thieu-b55/GPS-synchronized-clock/Klok met voet.jpg

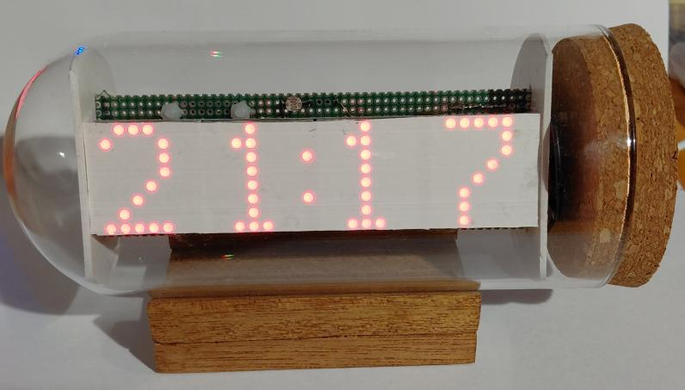
Klok met voet.jpg
