thieu-b55/GPS-synchronized-clock/GPS klok(NL).pdf

## GPS Klok

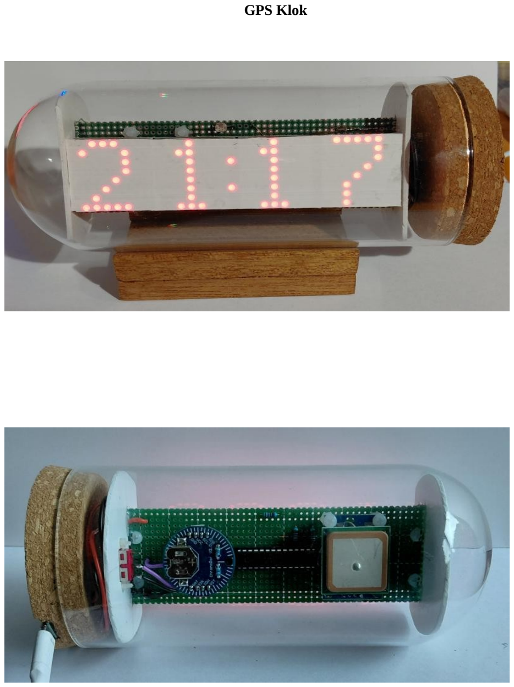
[picture p9: page 1]

GPS-gesynchroniseerde klok

Eenvoudige klok die altijd de juiste tijd aangeeft. GPS-ontvangst vereist.

De keuze tussen zomer- en wintertijd moet handmatig worden gemaakt.

Slechts enkele componenten en eenvoudig te bouwen, zelfs op een breadboard.

Gebouwd rond een ATMEGA328P-chip of bord.

Gebruik een Arduino Mini Pro 5V-versie om in de glazen stolp te monteren.

of

ATMEGA328P-chip met een voedingsspanning van 5 V.

De LED-matrix is niet compatibel met 3,3 V.

Gebruik de volgende instellingen bij gebruik van de ATMEGA328P-chip:

Bootloader: "Geen bootloader"

Klok: "Intern 8 MHz"

Geen financiële impact

Ideaal voor Arduino-beginners

Seriële communicatie

I2C-communicatie

SPI-communicatie

Analoge ingang

Digitale ingang

Interrupt-subroutine

Gebruik van een 2-dimensionale array

Prachtig eindresultaat

## Specificaties

Klok wordt elk uur gesynchroniseerd met de GPS ontvanger (indien satelliet ontvangst). Altijd de juiste tijd.

Lijn 80 van GPS_klok.ino

#define UTC_OFFSET | 1

Vul hier jouw locale UTC_OFFSET in

Zomertijd / wintertijd eenvoudig te selecteren met schakelaar

Automatische display intensiteit in functie van omgevingslicht.

Gemakkelijk te bouwen en geen aanslag op de financieën.

## Onderdelen

1x Arduino bord met ATMEGA328P
of
1x | ATMEGA328P
1x | DS3231SN ChronoDot V2.0 + 2x R4K7 >> | R1/R2
https://nl.aliexpress.com/item/1005009332338476.html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 %214.69%212.34%21%21%2138.51%2119.25%21%40211b6c1917536370904658336e3432%211 2000048781236369%21sea%21BE %21924161374%21X&curPageLogUid=JFnu30FcKDPL&utparam-url=scene%3Asearch %7Cquery_from%3A (https://nl.aliexpress.com/item/1005009332338476.html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)

1 x CR1225 voor ChronoDot V2.0 https://www.netwerkkabelshop.nl/camelion-cr1225-bp5-lithium-knoopcel-batterij?sqr=cr1225

1x NEO-7M met antenne
https://nl.aliexpress.com/item/1005007175919889.html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 %21EUR
%211.34%211.34%21%21%2111.04%2111.04%21%4021039a5b17536374796012318ee9d1%2112 000039706177745%21sea%21BE %21924161374%21X&curPageLogUid=BAHXqFwy2k1M&utparam-url=scene%3Asearch %7Cquery_from%3A (https://nl.aliexpress.com/item/1005007175919889.html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)

1x MAX7219 Dot Matrix module https://nl.aliexpress.com/item/1005005855156717.html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 %3ApcStoreLeaderboard%2Cscm-url%3A1007.22922.271278.0%2Cpvid%3A3fe1b220-b1d7-4e2f-b5e3-d1e34e24bb32%2Ctpp_buckets%3A668%232846%238114%231999&pdp_ext_f=%7B %22order%22%3A%22870%22%2C%22eval%22%3A%221%22%2C%22sceneId%22%3A %2212922%22%7D&pdp_npi=4%40dis%21EUR %211.81%211.81%21%21%212.08%212.08%21%40210390c917536376260361998e258a %2112000034586876016%21rec%21BE %21924161374%21XZ&spm=a2g0o.store_pc_home.smartLeaderboard_2003967183209.10050058 55156717&gatewayAdapt=glo2nld (https://nl.aliexpress.com/item/1005005855156717.html?scm_id=1007.22922.271278.0&scm-url=1007.22922.271278.0)

4x | R10K
1x | LDR
https://nl.aliexpress.com/item/1005007463254941.html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 %213.44%212.15%21%21%2128.27%2117.70%21%40210384b217536377355288146ebdfc %2112000040858660182%21sea%21BE (https://nl.aliexpress.com/item/1005007463254941.html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)

%21924161374%21X&curPageLogUid=Sqlee3HwjHsM&utparam-url=scene%3Asearch %7Cquery_from%3A#nav-specification (https://nl.aliexpress.com/item/1005007463254941.html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)

1x | ON/OFF schakelaar | >> | zomertid / winter tijd
1x | glazen stolp 18cm x 8cm
https://nl.aliexpress.com/item/1005003248974462.html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 %21EUR
%213.59%213.59%21%21%2129.48%2129.48%21%402103856417536380090745199eb900%211 2000040699183119%21sea%21BE %21924161374%21X&curPageLogUid=zXQY1aUUsCZe&utparam-url=scene%3Asearch %7Cquery_from%3A (https://nl.aliexpress.com/item/1005003248974462.html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)
Opmerking in verband met glazen stolp.
3 stuks besteld en alle 3 in goede staat aangekomen.

1x Voeding 5V.
MAX7219 Dot Matrix module is NIET 3.3V compatibel.

## Verbindingen

## GPS

VCC | >> | +5V
GND | >> | GND
RX | >> | 3
TX | >> | 4

## DS3231SN

VCC | >> | +5V
GND | >> | GND
SDA | >> | SDA (18 / A4)
SCL | >> | SCL (19 / A5)

+5V ----<R10K>-------- 2 (INT0)
| | SQW

PC board ChronoDot V2.0
R1 | >> | 4K7
R2 | >> | 4K7

## DOT MATRIX DISPLAY

VCC | >> | +5V
GND | >> | GND
CLK | >> | 13
CS | >> | 10
DIN | >> | 11

## SWITCH ZOMER / WINTER

GND ----| |---- 14 (A0)
N.O.
Contact open >> | summer time
Contact close >> | winter time

## LDR

+5V ----<LDR>---------<R10K>---- GND |
15 (A1)

## Enkele bouwtips

Dot matrix display

Om plaats te besparen verwijder de gemonteerde pinheader en plaats een nieuwe, maar dan 180° gedraaid. Zie afbeeldingen hieronder.

Origineel

Gedraaid


De kunstofcirkels, gebruikt om alles op zijn plaats te houden zijn gemaakt van

Foamalux Light PVC wit DIY 2mm

In Belgie verkrijgbaar bij
Gamma
Brico

Plaat 0.5m x 1m x 2mm

Linker cirkel | diameter | 72mm
Rechter cirkel | diameter | 75mm

Dit kan gemakkelijk met een schaar geknipt worden.

ChronoDot V2.0
Plaats weerstanden van 4K7 in de posities R1 en R2

Enkele afbeeldingen van alles samen



Voor programma zie:

https://github.com/thieu-b55/GPS-synchronized-clock

dat was het,
groeten en veel bouwplezier,

thieu-b55
augustus 2025
